joshr120/CANBUS-Stepper/Getting Started/README.md

# **CANBUS Stepper** - Getting Started
If you just received your CANBUS Stepper this will show you how to spin a motor and configure the driver using the web GUI.

Web GUI: [thingsbyjosh.com/canbus_gui](https://thingsbyjosh.com/canbus_gui)

## Assembling a kit onto a Nema 17 ##
For easiest assembly your motor should have the stardard 6 pin JST PH connector, and the included screws (M3x40mm) are best suited for a 34mm length motor.
For example the Hanpose 17HS3401S, available on [Amazon](https://www.amazon.com/Captive-Stepper-17HS3401S-4-Lead-Printer/dp/B0G9KRJFTY) and [Aliexpress](https://www.aliexpress.com/item/1005006577156384.html).

### 1. Install the magnet onto your motor (only needed for reading encoder position)
   
   Carefully superglue the included diametrically magnitised magnet onto the centre of the motor shaft.  

   Only a very small amount of glue is required, take care not to get any in the motor bearing.  
   
   

### 2. Remove the original motor screws



### 3. Peel off the protective film and add one of the included heat pads onto the heat spreader

  Ensure this is added on the recessed side of the heat spreader




### 4. Place the spacer onto the motor ensuring it is in the orientation show relative to the motor connector



### 5. Add the PCB

Again ensure the PCB is installed in the orientation shown so the motor connectors as well as the heat pad line up



### 5. Add the cover and new countersunk screws

   The included screws are best suited for a 34mm length Nema 17 you may need longer or shorter ones depending on your motor. (included ones are M3x40mm)
   
   
   

### 6. Add the heatsink

   Use the larger heatsink if you plan on running the motor for long periods and/or at high currents
   
   
   

### 7. Plug in motor loom

 There are 2 looms provided in the kit for different motors, try one and if in the next steps your motor stutters/doesnt spin, power off the board and try the other one. 

  Note. Do not disconnect/connect the motor while the board is powered.

  

## Power on the Board

Connect a 12V or 24V supply to the "PWR IN" connector. A standard XT30 connector can be used for power.



You can power the board via the USB Type-C connector for configuration and monitoring, but you will NOT be able to power/move the motor. (See the [PD Stepper](https://thingsbyjosh.com/products/pd-stepper) if you want a USB PD powered stepper motor driver)

## Daisy Chaining Boards
Pay attention to the IN vs OUT labels on the Power connectors. 



⚠️ When daisy chaining nodes together set the "CAN TERM" DIP switch ON for the two boards at each end of the string, and OFF for all others.

⚠️ Every node/board on a bus needs a unique node ID. This is set by holding down the SW1 button while powering on a node. The number of times the LED flashes before releasing the button is the new Node ID (upto 31).

## Using the Web GUI

The Web GUI can be used to control, configure and program the CANBUS Stepper.

It is viewable online at [thingsbyjosh.com/canbus_gui](https://thingsbyjosh.com/canbus_gui)

1. Connect your CANBUS Stepper board to a PC via the USB type-C connector on the PCB.
2. Open the Web GUI, press "Connect via USB" and select your board. On windows machines this will come up as something like "USB JTAG/serial debug unit (COMxx)". You can also find the COM port number by opening device manager on your PC.

<p float="left">
  
   
</p>

3. View all discovered Nodes by pressing "x Nodes Found" on the bottom right. Click on a node to view it (or select the node ID with "TARGET NODE" on the top right). Setting the "TARGET NODE" to "0" will send the command to all nodes on the bus.
4. Configure Node Device Settings by double clicking the value. After testing the change behaves as expected press "SAVE TO FLASH" to keep the values between power cycles.
5. You can update your CANBUS Stepper to the latest software by using the UPDATE FIRMWARE button and automatically flashing the latest firmware pulled right from this GitHub:

<p float="left">
  
   
</p>

6. Once connected via USB you can enable configure WiFi information to wirelessly connect over websockets. You can then disconnect from USB and connect via WiFi with either the hostname "canbus-stepper-[NODE ID].local" or the IP address of the node. 

<p float="left">
  
   
</p>
(Note that analog input functionality of the AUX connector will not be usable when WiFI is enabled due to an IO clash).

## Closed Loop Control

To enable closed loop control in the web GUI:

1. Under "LIVE TELEMETRY, take note of the "Encoder Angle (deg)" value.
2. Change the "Set Position (deg)" to 360 by double clicking the value.
3. The "Encoder Angle (deg)" should increase by 360 deg ± 1 deg. If this instead decreases by 360 set the "Map Direction" to 1. If it increases by 180 degrees, set the "Steps per Rev" to 400.
4. Change "Closed Loop Type" to 1.
5. Once confirmed working, press "Save to Flash" to remember settings next power cycle.

## Sensorless Homing

Sensorless homing is available via the StallGuard feature of the TMC2209 driver. This allows the motor to find a home position by detecting an increase in the motor load once it reaches a hard stop. The CAN Node software exposes this for easy use.

The procedure for sensorless homing it is as follows:

  1. Set "Stallguard Behaviour" (MsgType 7) to 4.

  2. Set "Set Velocity (deg/sec)" (MsgType 3) to your desired speed / direction.

Once the stall guard is triggered it will stop the motor and reset the zero position. (other stall behaviours can also be set by changing the "Stallguard Behaviour")

You can adjust the "Stallguard Threshold" (MsgType 12) to change at what motor load this is triggered, and live view "Stallguard Value" to view the live value. All configurable via the web GUI.

## Serial Control

To control a CANBUS Stepper node (or systems of nodes) over hardware serial, the AUX connector can be configured for serial Control.

Double click the "AUX Connector" setting, and select "Serial Control"



Serial control is at 115200 Baud, format 8N1. Serial messages follow the same format as CAN packets. See the CAN Protocol document for more information.

You will always still be able to use the USB serial connection as well.

## Custom CAN Messages

There is a CAN message builder on the top right which allows CAN messaged to be built up. This is useful for debugging CAN messages when building your own control interface.

See the CAN Protocol document for for info on the CAN packet structure.
