joshr120/CANBUS-Stepper/(commit log)

2026-05-10 Stallguard / sensorless homing functionality added
    [CANBUS_Stepper_Node.ino]
2026-05-10 Update README.md to add sensorless homing note
2026-05-22 Update README.md with assembly instructions
2026-07-05 Update the web GUI to have a small grey STOP button for the Estop where you would usually double click to enter a valueDiagnosing null message type blocking emergency stop functionalityDiagnosing nul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
2026-08-07 Software V0.10, bug fixes
    [CANBUS_Stepper_Node.ino]
2026-09-11 V0.13 node firmware, fault reporting, better closed loop control, various bug fixes etc
    [CANBUS_Stepper_Node.ino]
2026-09-13 V0.14 software, hold current and incremental move added
2026-10-17 V0.15 software, added WiFi / websocket wireless control and new step generation interrupts
2026-10-17 Update README.md with wireless control info
